petercipov/MeaterPi/hardware/MeaterPi_PCB/drc-report.txt

** Drc report for MeaterPi_PCB.kicad_pcb **
** Created on 2026-05-08T21:17:46 **
** Report includes: Errors, Warnings, Exclusions **

** Found 18 DRC violations **
[lib_footprint_issues]: The current configuration does not include the footprint library 'Connector'
    Local override; warning
    @(10.0000 mm, 11.0000 mm): Footprint J1
[lib_footprint_issues]: The current configuration does not include the footprint library 'Fuse'
    Local override; warning
    @(20.0000 mm, 19.0000 mm): Footprint F1
[lib_footprint_issues]: The current configuration does not include the footprint library 'Package_TO_SOT_THT'
    Local override; warning
    @(31.0000 mm, 19.0000 mm): Footprint Q2
[lib_footprint_issues]: The current configuration does not include the footprint library 'Resistor_SMD'
    Local override; warning
    @(31.0000 mm, 26.0000 mm): Footprint R7
[lib_footprint_issues]: The current configuration does not include the footprint library 'Diode_SMD'
    Local override; warning
    @(43.0000 mm, 19.0000 mm): Footprint D1
[lib_footprint_issues]: The current configuration does not include the footprint library 'Capacitor_THT'
    Local override; warning
    @(60.0000 mm, 21.0000 mm): Footprint C1
[lib_footprint_issues]: The current configuration does not include the footprint library 'Capacitor_SMD'
    Local override; warning
    @(60.0000 mm, 31.0000 mm): Footprint C2
[lib_footprint_issues]: The current configuration does not include the footprint library 'Module'
    Local override; warning
    @(8.0000 mm, 27.0000 mm): Footprint U1
[lib_footprint_issues]: The current configuration does not include the footprint library 'Connector_PinSocket_2.54mm'
    Local override; warning
    @(14.0000 mm, 42.0000 mm): Footprint J2
[lib_footprint_issues]: The current configuration does not include the footprint library 'Connector'
    Local override; warning
    @(27.0000 mm, 11.0000 mm): Footprint J3
[lib_footprint_issues]: The current configuration does not include the footprint library 'Connector_PinHeader_2.54mm'
    Local override; warning
    @(47.0000 mm, 11.0000 mm): Footprint J4
[lib_footprint_issues]: The current configuration does not include the footprint library 'Package_TO_SOT_SMD'
    Local override; warning
    @(50.0000 mm, 19.0000 mm): Footprint Q1
[lib_footprint_issues]: The current configuration does not include the footprint library 'Resistor_SMD'
    Local override; warning
    @(42.0000 mm, 31.0000 mm): Footprint R2
[lib_footprint_issues]: The current configuration does not include the footprint library 'Resistor_SMD'
    Local override; warning
    @(50.0000 mm, 35.0000 mm): Footprint R3
[lib_footprint_issues]: The current configuration does not include the footprint library 'Resistor_SMD'
    Local override; warning
    @(42.0000 mm, 35.0000 mm): Footprint R5
[lib_footprint_issues]: The current configuration does not include the footprint library 'Resistor_SMD'
    Local override; warning
    @(46.0000 mm, 35.0000 mm): Footprint R6
[lib_footprint_issues]: The current configuration does not include the footprint library 'Resistor_SMD'
    Local override; warning
    @(46.0000 mm, 31.0000 mm): Footprint R4
[lib_footprint_issues]: The current configuration does not include the footprint library 'Capacitor_SMD'
    Local override; warning
    @(60.0000 mm, 27.0000 mm): Footprint C3

** Found 44 unconnected pads **
[unconnected_items]: Missing connection between items
    Local override; error
    @(10.5400 mm, 27.0000 mm): PTH pad 2 [GND] of U1
    @(15.6200 mm, 27.0000 mm): PTH pad 4 [GND] of U1
[unconnected_items]: Missing connection between items
    Local override; error
    @(15.6200 mm, 27.0000 mm): PTH pad 4 [GND] of U1
    @(19.0800 mm, 39.4600 mm): PTH pad 6 [GND] of J2
[unconnected_items]: Missing connection between items
    Local override; error
    @(19.0800 mm, 39.4600 mm): PTH pad 6 [GND] of J2
    @(24.1600 mm, 42.0000 mm): PTH pad 9 [GND] of J2
[unconnected_items]: Missing connection between items
    Local override; error
    @(24.1600 mm, 42.0000 mm): PTH pad 9 [GND] of J2
    @(29.2400 mm, 39.4600 mm): PTH pad 14 [GND] of J2
[unconnected_items]: Missing connection between items
    Local override; error
    @(27.0000 mm, 11.0000 mm): PTH pad 1 [GND] of J3
    @(15.0800 mm, 11.0000 mm): PTH pad 2 [GND] of J1
[unconnected_items]: Missing connection between items
    Local override; error
    @(27.0000 mm, 11.0000 mm): PTH pad 1 [GND] of J3
    @(32.0000 mm, 26.0000 mm): Pad 2 [GND] of R7 on F.Cu
[unconnected_items]: Missing connection between items
    Local override; error
    @(32.0000 mm, 26.0000 mm): Pad 2 [GND] of R7 on F.Cu
    @(29.2400 mm, 39.4600 mm): PTH pad 14 [GND] of J2
[unconnected_items]: Missing connection between items
    Local override; error
    @(36.8600 mm, 39.4600 mm): PTH pad 20 [GND] of J2
    @(29.2400 mm, 39.4600 mm): PTH pad 14 [GND] of J2
[unconnected_items]: Missing connection between items
    Local override; error
    @(44.4800 mm, 42.0000 mm): PTH pad 25 [GND] of J2
    @(49.5600 mm, 39.4600 mm): PTH pad 30 [GND] of J2
[unconnected_items]: Missing connection between items
    Local override; error
    @(44.4800 mm, 42.0000 mm): PTH pad 25 [GND] of J2
    @(36.8600 mm, 39.4600 mm): PTH pad 20 [GND] of J2
[unconnected_items]: Missing connection between items
    Local override; error
    @(45.0000 mm, 19.0000 mm): Pad 2 [GND] of D1 on F.Cu
    @(50.9500 mm, 19.9500 mm): Pad 2 [GND] of Q1 on F.Cu
[unconnected_items]: Missing connection between items
    Local override; error
    @(45.0000 mm, 19.0000 mm): Pad 2 [GND] of D1 on F.Cu
    @(47.0000 mm, 11.0000 mm): PTH pad 1 [GND] of J4
[unconnected_items]: Missing connection between items
    Local override; error
    @(49.5600 mm, 39.4600 mm): PTH pad 30 [GND] of J2
    @(51.0000 mm, 35.0000 mm): Pad 2 [GND] of R3 on F.Cu
[unconnected_items]: Missing connection between items
    Local override; error
    @(51.0000 mm, 35.0000 mm): Pad 2 [GND] of R3 on F.Cu
    @(47.0000 mm, 35.0000 mm): Pad 2 [GND] of R6 on F.Cu
[unconnected_items]: Missing connection between items
    Local override; error
    @(54.6400 mm, 39.4600 mm): PTH pad 34 [GND] of J2
    @(49.5600 mm, 39.4600 mm): PTH pad 30 [GND] of J2
[unconnected_items]: Missing connection between items
    Local override; error
    @(54.6400 mm, 39.4600 mm): PTH pad 34 [GND] of J2
    @(62.2600 mm, 42.0000 mm): PTH pad 39 [GND] of J2
[unconnected_items]: Missing connection between items
    Local override; error
    @(54.6400 mm, 39.4600 mm): PTH pad 34 [GND] of J2
    @(61.0000 mm, 31.0000 mm): Pad 2 [GND] of C2 on F.Cu
[unconnected_items]: Missing connection between items
    Local override; error
    @(61.0000 mm, 27.0000 mm): Pad 2 [GND] of C3 on F.Cu
    @(62.5000 mm, 21.0000 mm): PTH pad 2 [GND] of C1
[unconnected_items]: Missing connection between items
    Local override; error
    @(61.0000 mm, 31.0000 mm): Pad 2 [GND] of C2 on F.Cu
    @(61.0000 mm, 27.0000 mm): Pad 2 [GND] of C3 on F.Cu
[unconnected_items]: Missing connection between items
    Local override; error
    @(62.5000 mm, 21.0000 mm): PTH pad 2 [GND] of C1
    @(50.9500 mm, 19.9500 mm): Pad 2 [GND] of Q1 on F.Cu
[unconnected_items]: Missing connection between items
    Local override; error
    @(10.0000 mm, 11.0000 mm): PTH pad 1 [+12V_IN] of J1
    @(18.5125 mm, 19.0000 mm): Pad 1 [+12V_IN] of F1 on F.Cu
[unconnected_items]: Missing connection between items
    Local override; error
    @(21.4875 mm, 19.0000 mm): Pad 2 [+12V_FUSED] of F1 on F.Cu
    @(36.0800 mm, 19.0000 mm): PTH pad 3 [+12V_FUSED] of Q2
[unconnected_items]: Missing connection between items
    Local override; error
    @(8.0000 mm, 27.0000 mm): PTH pad 1 [+12V_PROT] of U1
    @(33.5400 mm, 19.0000 mm): PTH pad 2 [+12V_PROT] of Q2
[unconnected_items]: Missing connection between items
    Local override; error
    @(33.5400 mm, 19.0000 mm): PTH pad 2 [+12V_PROT] of Q2
    @(41.0000 mm, 19.0000 mm): Pad 1 [+12V_PROT] of D1 on F.Cu
[unconnected_items]: Missing connection between items
    Local override; error
    @(41.0000 mm, 19.0000 mm): Pad 1 [+12V_PROT] of D1 on F.Cu
    @(49.5400 mm, 11.0000 mm): PTH pad 2 [+12V_PROT] of J4
[unconnected_items]: Missing connection between items
    Local override; error
    @(59.0000 mm, 31.0000 mm): Pad 1 [+12V_PROT] of C2 on F.Cu
    @(60.0000 mm, 21.0000 mm): PTH pad 1 [+12V_PROT] of C1
[unconnected_items]: Missing connection between items
    Local override; error
    @(60.0000 mm, 21.0000 mm): PTH pad 1 [+12V_PROT] of C1
    @(49.5400 mm, 11.0000 mm): PTH pad 2 [+12V_PROT] of J4
[unconnected_items]: Missing connection between items
    Local override; error
    @(13.0800 mm, 27.0000 mm): PTH pad 3 [+5V] of U1
    @(14.0000 mm, 39.4600 mm): PTH pad 2 [+5V] of J2
[unconnected_items]: Missing connection between items
    Local override; error
    @(14.0000 mm, 39.4600 mm): PTH pad 2 [+5V] of J2
    @(16.5400 mm, 39.4600 mm): PTH pad 4 [+5V] of J2
[unconnected_items]: Missing connection between items
    Local override; error
    @(29.0000 mm, 11.0000 mm): PTH pad 2 [+5V] of J3
    @(13.0800 mm, 27.0000 mm): PTH pad 3 [+5V] of U1
[unconnected_items]: Missing connection between items
    Local override; error
    @(59.0000 mm, 27.0000 mm): Pad 1 [+5V] of C3 on F.Cu
    @(29.0000 mm, 11.0000 mm): PTH pad 2 [+5V] of J3
[unconnected_items]: Missing connection between items
    Local override; error
    @(14.0000 mm, 42.0000 mm): PTH pad 1 [+3V3] of J2
    @(34.3200 mm, 42.0000 mm): PTH pad 17 [+3V3] of J2
[unconnected_items]: Missing connection between items
    Local override; error
    @(34.3200 mm, 42.0000 mm): PTH pad 17 [+3V3] of J2
    @(45.0000 mm, 31.0000 mm): Pad 1 [+3V3] of R4 on F.Cu
[unconnected_items]: Missing connection between items
    Local override; error
    @(16.5400 mm, 42.0000 mm): PTH pad 3 [SDA] of J2
    @(31.0000 mm, 11.0000 mm): PTH pad 3 [SDA] of J3
[unconnected_items]: Missing connection between items
    Local override; error
    @(19.0800 mm, 42.0000 mm): PTH pad 5 [SCL] of J2
    @(33.0000 mm, 11.0000 mm): PTH pad 4 [SCL] of J3
[unconnected_items]: Missing connection between items
    Local override; error
    @(26.7000 mm, 42.0000 mm): PTH pad 11 [FAN_PWM_GPIO17] of J2
    @(41.0000 mm, 31.0000 mm): Pad 1 [FAN_PWM_GPIO17] of R2 on F.Cu
[unconnected_items]: Missing connection between items
    Local override; error
    @(43.0000 mm, 31.0000 mm): Pad 2 [FAN_PWM_GATE] of R2 on F.Cu
    @(49.0000 mm, 35.0000 mm): Pad 1 [FAN_PWM_GATE] of R3 on F.Cu
[unconnected_items]: Missing connection between items
    Local override; error
    @(49.0500 mm, 19.9500 mm): Pad 1 [FAN_PWM_GATE] of Q1 on F.Cu
    @(43.0000 mm, 31.0000 mm): Pad 2 [FAN_PWM_GATE] of R2 on F.Cu
[unconnected_items]: Missing connection between items
    Local override; error
    @(50.0000 mm, 18.0500 mm): Pad 3 [FAN_PWM_OD] of Q1 on F.Cu
    @(54.6200 mm, 11.0000 mm): PTH pad 4 [FAN_PWM_OD] of J4
[unconnected_items]: Missing connection between items
    Local override; error
    @(41.0000 mm, 35.0000 mm): Pad 1 [FAN_TACH] of R5 on F.Cu
    @(47.0000 mm, 31.0000 mm): Pad 2 [FAN_TACH] of R4 on F.Cu
[unconnected_items]: Missing connection between items
    Local override; error
    @(47.0000 mm, 31.0000 mm): Pad 2 [FAN_TACH] of R4 on F.Cu
    @(52.0800 mm, 11.0000 mm): PTH pad 3 [FAN_TACH] of J4
[unconnected_items]: Missing connection between items
    Local override; error
    @(43.0000 mm, 35.0000 mm): Pad 2 [FAN_TACH_GPIO27] of R5 on F.Cu
    @(29.2400 mm, 42.0000 mm): PTH pad 13 [FAN_TACH_GPIO27] of J2
[unconnected_items]: Missing connection between items
    Local override; error
    @(45.0000 mm, 35.0000 mm): Pad 1 [FAN_TACH_GPIO27] of R6 on F.Cu
    @(43.0000 mm, 35.0000 mm): Pad 2 [FAN_TACH_GPIO27] of R5 on F.Cu
[unconnected_items]: Missing connection between items
    Local override; error
    @(30.0000 mm, 26.0000 mm): Pad 1 [REV_GATE] of R7 on F.Cu
    @(31.0000 mm, 19.0000 mm): PTH pad 1 [REV_GATE] of Q2

** Found 0 Footprint errors **

** Ignored checks **
    - Footprint has no courtyard defined
    - Track endpoint not centered on via
    - Tuning profile track geometries
    - Footprint doesn't match symbol's footprint filters
    - Footprint component type doesn't match footprint pads

** End of Report **
