petercipov/MeaterPi/hardware/MeaterPi_PCB/erc-report.txt

ERC report (2026-05-08T21:13:57, Encoding UTF8)
Report includes: Errors, Warnings, Exclusions

***** Sheet /
[footprint_link_issues]: The current configuration does not include the footprint library 'TerminalBlock'
    ; warning
    @(35.00 mm, 60.00 mm): Symbol J1 [Conn_01x02]
[footprint_link_issues]: The current configuration does not include the footprint library 'Fuse'
    ; warning
    @(60.00 mm, 56.00 mm): Symbol F1 [Fuse]

 ** ERC messages: 2  Errors 0  Warnings 2

 ** Ignored checks:
    - Global label only appears once in the schematic
    - Four connection points are joined together
    - SPICE model issue
    - Assigned footprint doesn't match footprint filters
