petercipov/MeaterPi/(commit log)

2026-05-06 adding pressure
2026-05-06 fix pressure
2026-05-08 adding connectors
2026-05-08 adding board with psu on it
    [MeaterPi_PCB.kicad_pcb, MeaterPi_PCB.kicad_sch]
2026-05-08 smaller version wirh power extrnal
    [MeaterPi_PCB.kicad_pcb, MeaterPi_PCB.kicad_sch]
2026-05-16 added schema for fan
    [MeaterPi_PCB.kicad_pcb, MeaterPi_PCB.kicad_sch]
2026-05-16 adding fan test
2026-05-16 fix pwm
